kaien04/TTR9.5eco_VCU/README.md

# TTR9.5eco VCU 專案

This is for Taipei Tech Racing TTR9.5eco vehicle VCU project file

## 專案內容
- VCU 相關電路設計圖

## 開發資訊
- 開發者：陳楷恩
- 適用賽事：節能車大賽 / FSAE相關規格參考
