kaien04/TTR9.5eco_VCU/TTR9.5eco-VCU/Hardware/release/v2.0/3dmodel/TTR9.5eco_VCU.step

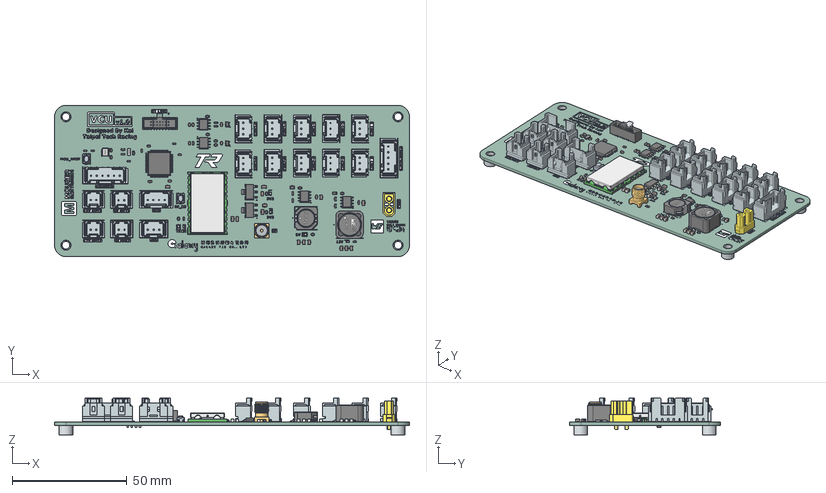
[picture p1: CAD file, 2026-05-07]
TTR9.5eco-VCU/Hardware/release/v2.0/3dmodel/TTR9.5eco_VCU.step
154.9 x 66.0 x 16.0 mm
R_0603_1608Metric x 18
C_0805_2012Metric x 15
C_0603_1608Metric x 25
Texas_HTSOP-8-1EP_3.9x4.9mm_P1.27mm_EP2.85x4.9mm_Mask2.4x3.1mm_ ThermalVias x 2
SOT-323_SC-70 x 2
Pins x 2
Cover x 2
LED_0603_1608Metric x 6
TTR9.5eco_VCU 1.38 x 2
Core
ShieldRing
Glue
Leadframe
SOIC-8_3.9x4.9mm_P1.27mm x 2
R_0805_2012Metric x 2
SOT-223 x 2
PCB
asmPad x 16
solderPin x 23
AMB004F
AMB004C
shielding ring
core
base x 2
glue
XT30_Buchse
LQFP-64_10x10mm_P0.5mm
6270xx20621_PIN x 14
6273xx20621_Cap
L_0603_1608Metric
TTR9.5eco_VCU_silkscreen
TTR9.5eco_VCU_PCB
