kaien04/TTR9.5eco_VCU/TTR9.5eco-VCU/Hardware/release/v2.0/schematic/TTR9.5eco_VCU.pdf

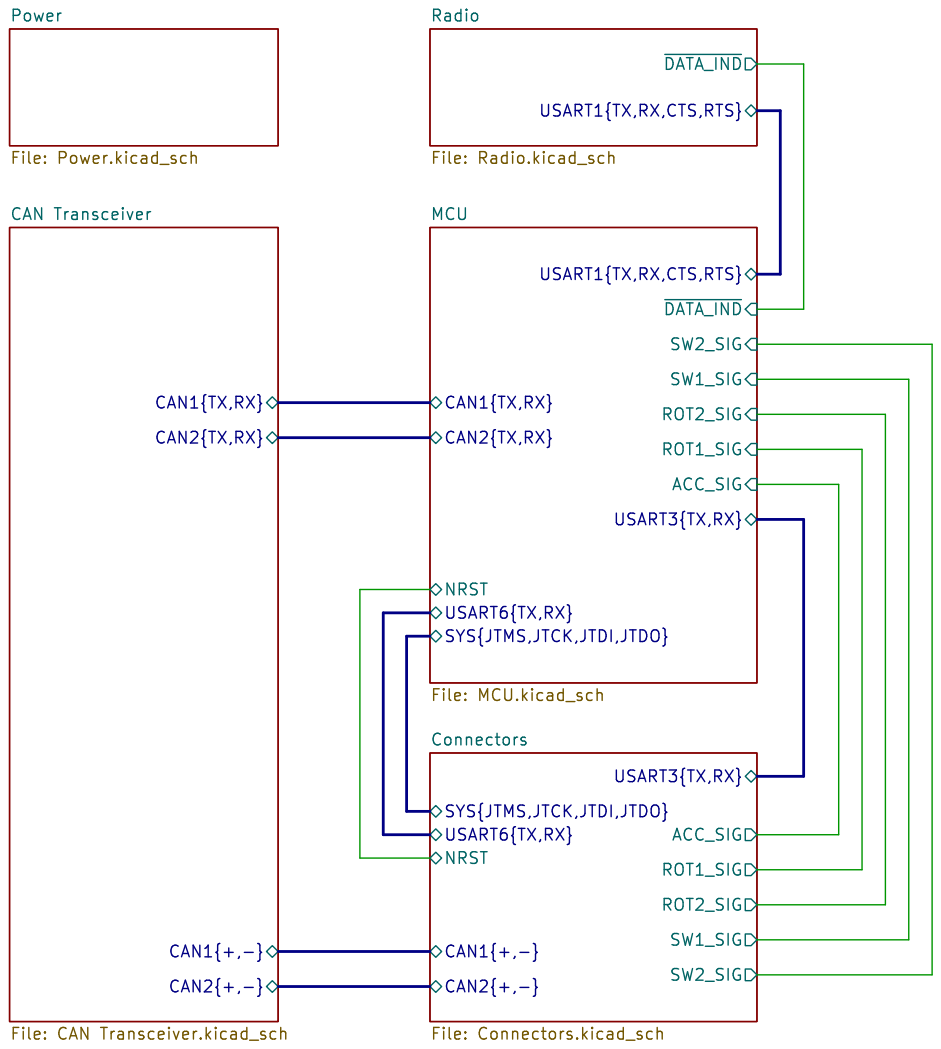
[picture p2: page 1]

USART1{TX,RX,CTS,RTS} ROT1_SIG

USART6{TX,RX}
SYS{JTMS,JTCK,JTDI,JTDO}

USART6{TX,RX} Connectors File: Connectors.kicad_sch

NRST SYS{JTMS,JTCK,JTDI,JTDO}

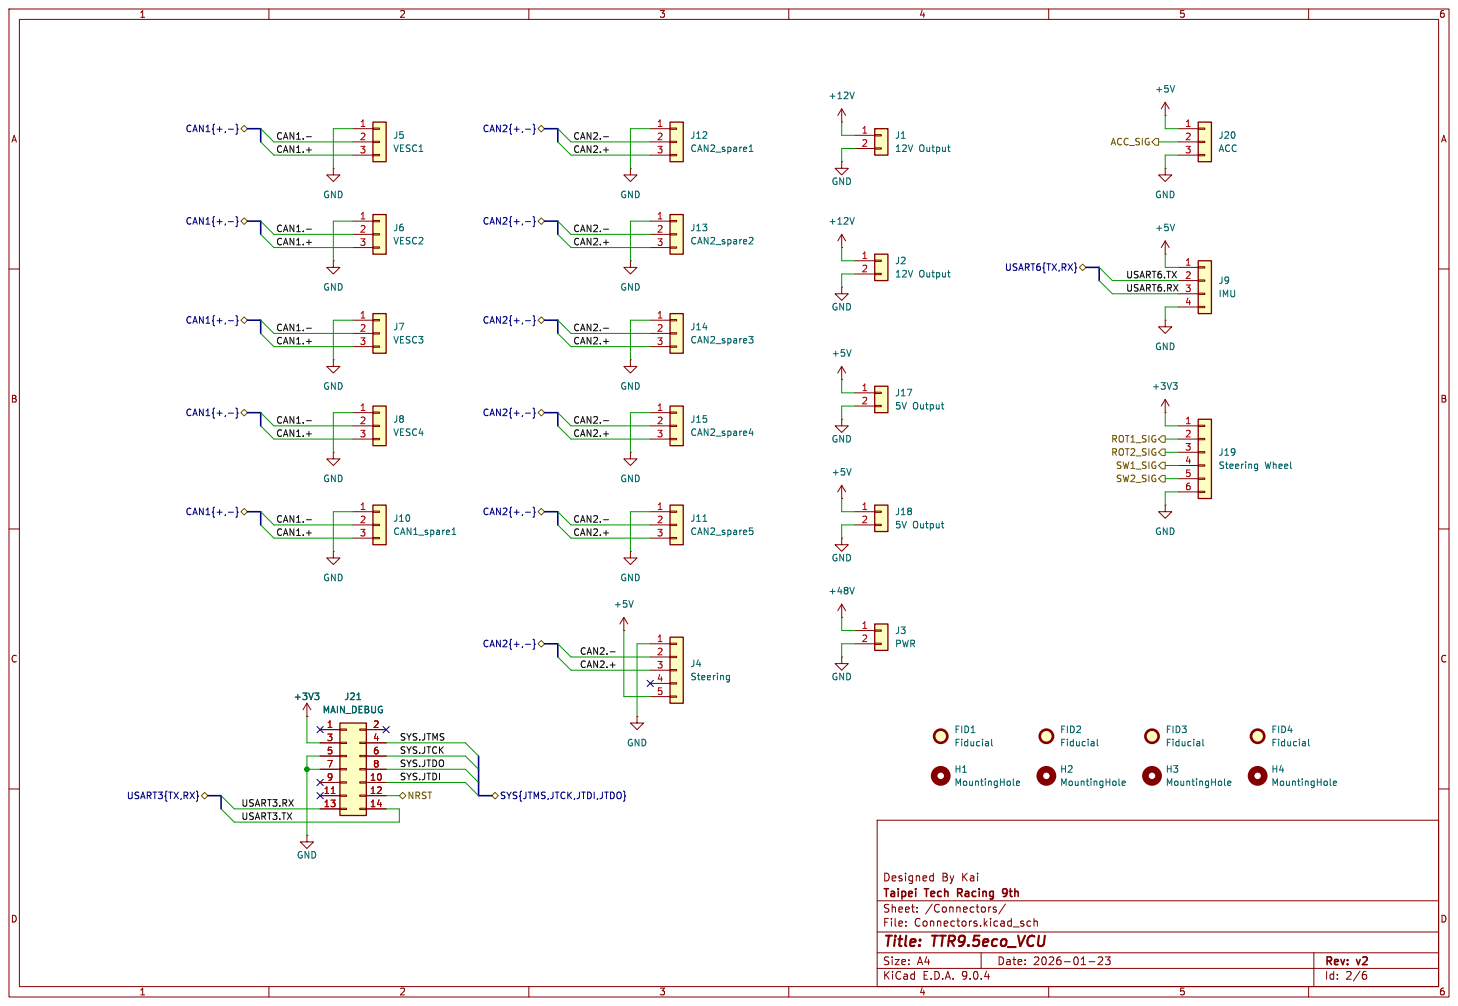
[picture p3: page 2]

SYS{JTMS,JTCK,JTDI,JTDO}

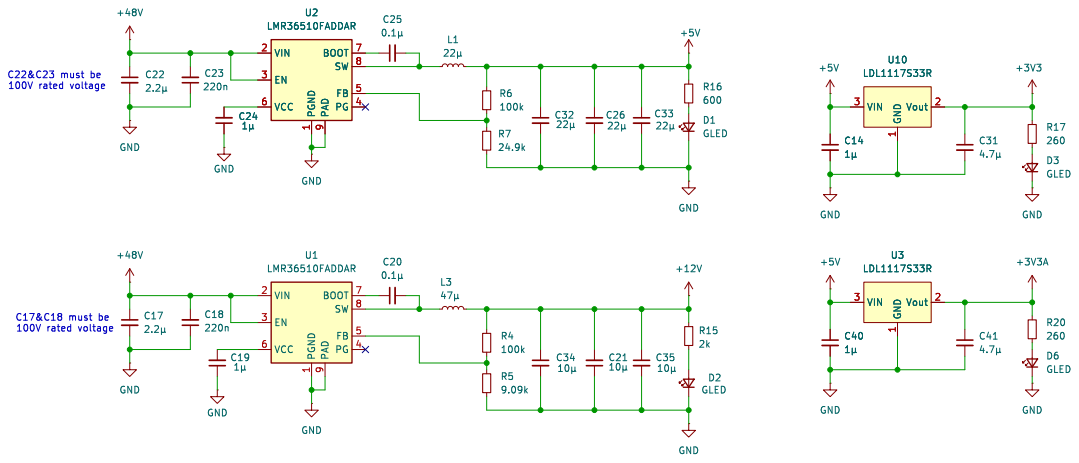
[picture p4: page 3]

100V rated voltage C17&C18 must be

9 BOOT 7 SW 8 FB 5 PG 4 U3

9 BOOT 7 SW 8 FB 5 PG 4 U1

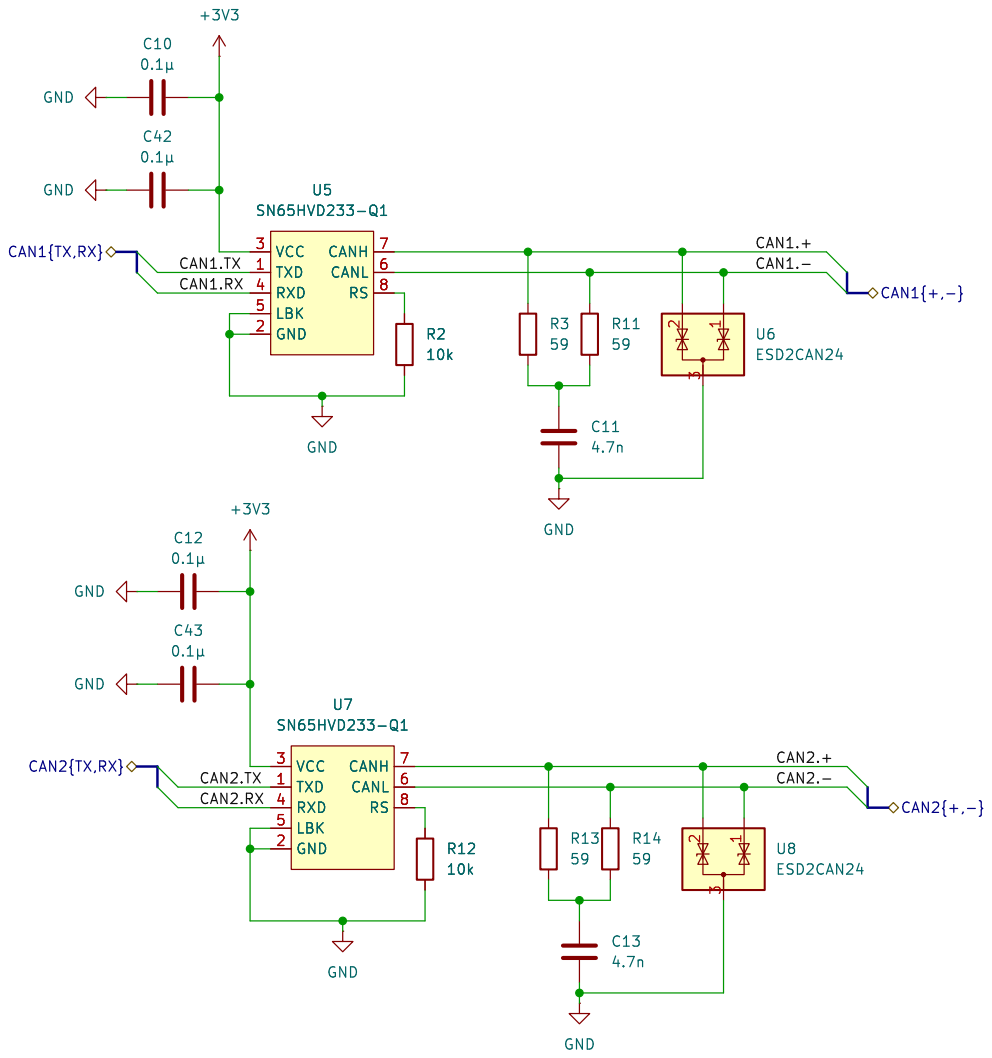
[picture p5: page 4]

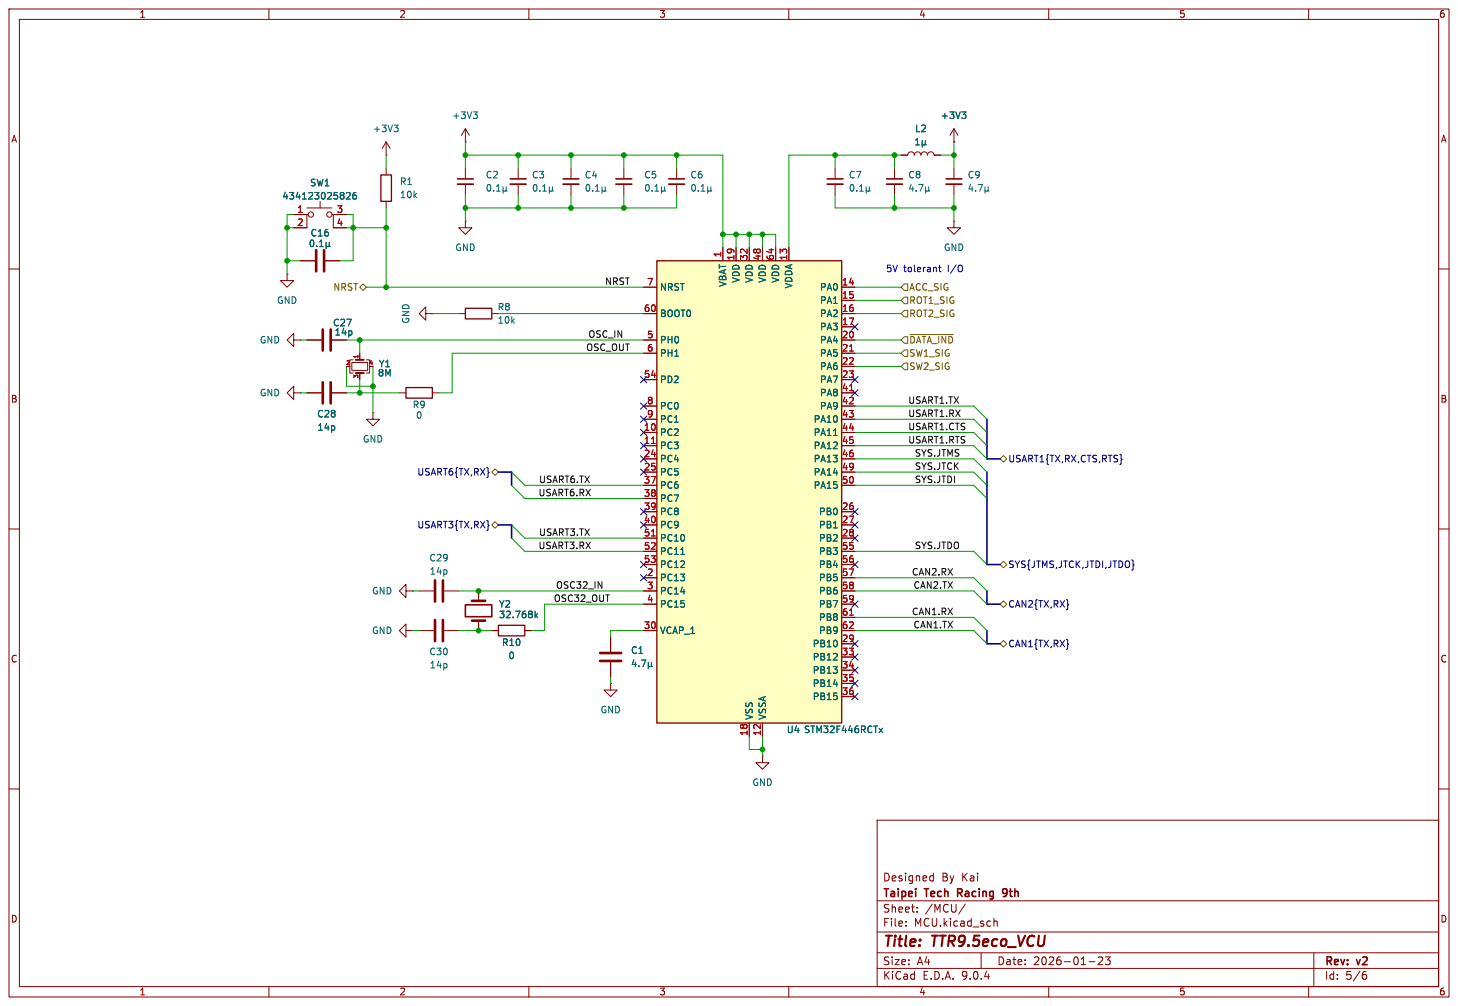
[picture p6: page 5]

USART1{TX,RX,CTS,RTS} ACC_SIG

USART1.TX USART3.RX USART3.TX USART6.TX USART6.RX OSC32_OUT OSC32_IN

SYS.JTDI SYS.JTMS

SYS{JTMS,JTCK,JTDI,JTDO}

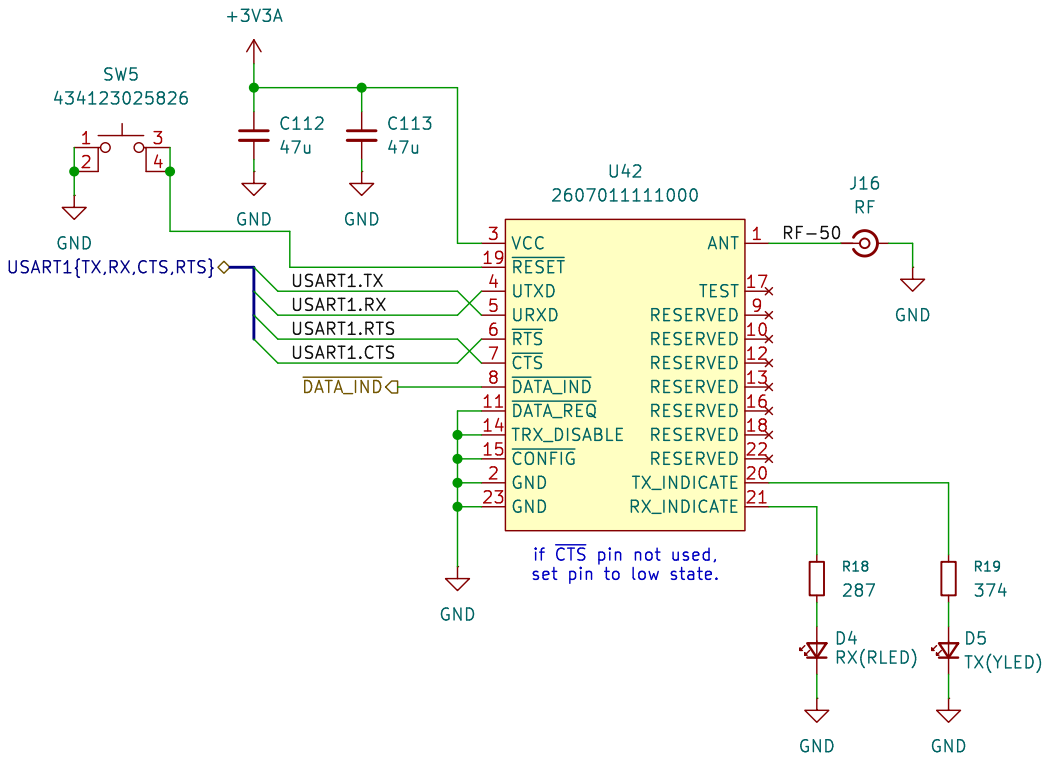
[picture p7: page 6]

if ~{CTS}pin not used, set pin to low state.
