kaien04/TTR9.5eco_VCU/TTR9.5eco-VCU/Hardware/TTR9.5eco_VCU.kicad_pcb

## KiCad design TTR9.5eco-VCU/Hardware/TTR9.5eco_VCU.kicad_pcb (2026-05-07)

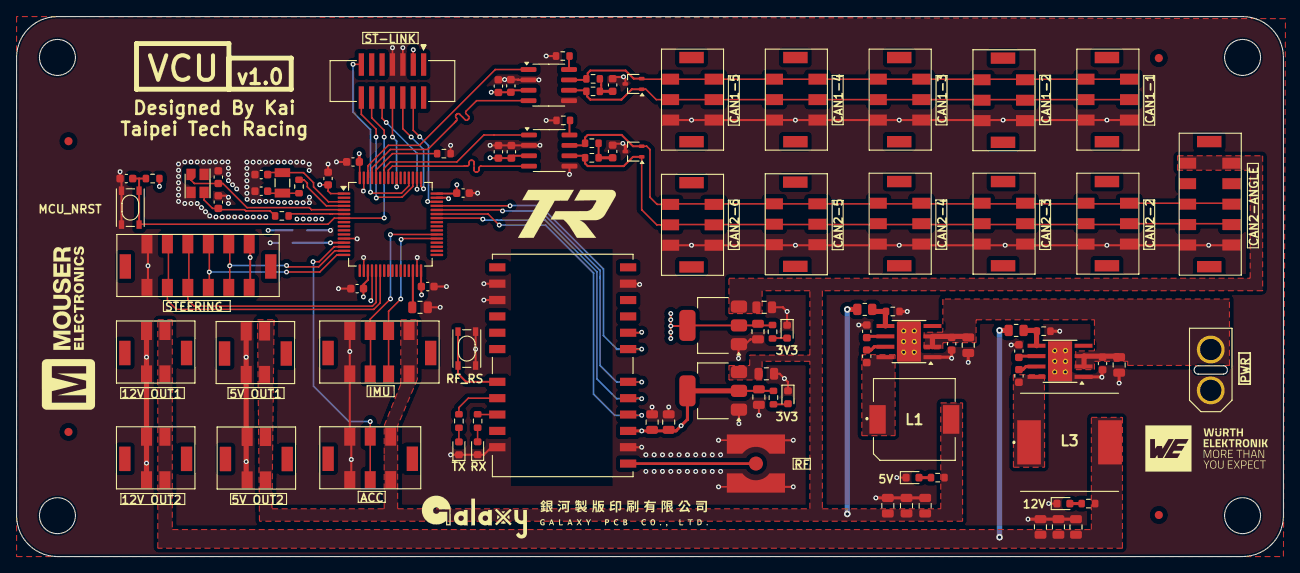
[picture p8: board TTR9.5eco_VCU.kicad_pcb from above]

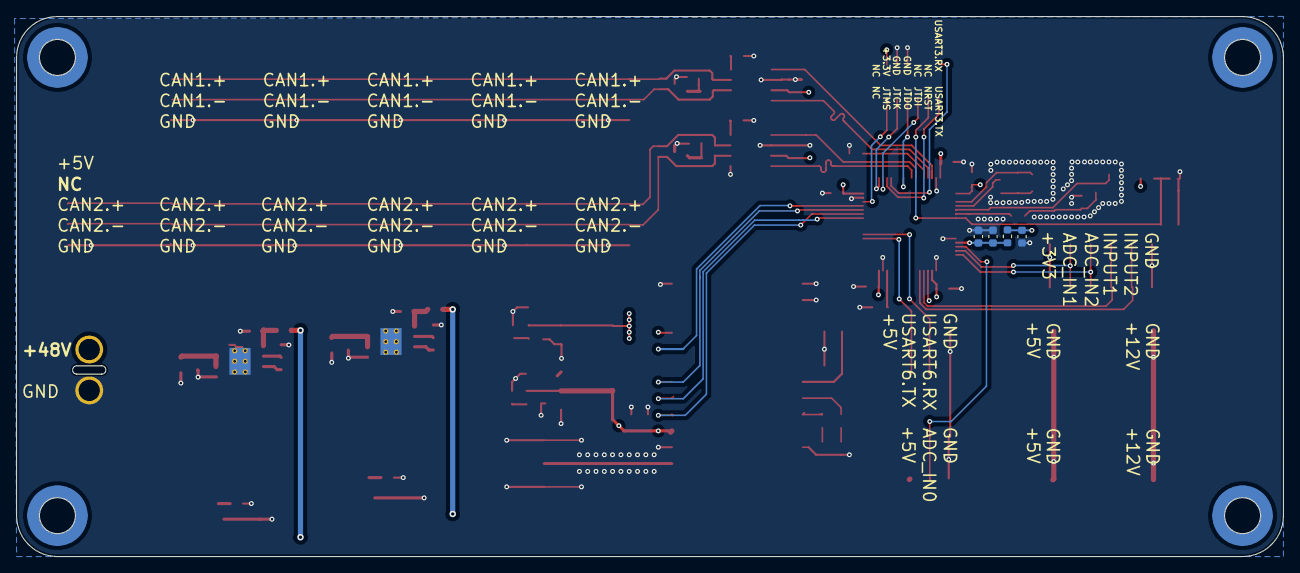
[picture p9: board TTR9.5eco_VCU.kicad_pcb from below]

Board: 4 copper layers, 154.9 x 66.0 mm, 112 parts (8 on the bottom side), 64 nets.

Parts:
C1, C31, C41: 4.7μ; C_0805_2012Metric
C2, C3, C4, C5, C6, C7, C10, C12, C16, C20, C25, C42, C43: 0.1μ; C_0603_1608Metric
C8, C9: 4.7μ; C_0603_1608Metric
C11, C13: 4.7n; C_0603_1608Metric
C14, C40: 1μ; C_0805_2012Metric
C17, C22: 2.2μ; C_0805_2012Metric
C18, C23: 220n; C_0603_1608Metric
C19, C24: 1μ; C_0603_1608Metric
C21, C34, C35: 10μ; C_0805_2012Metric
C26, C32, C33: 22μ; C_0805_2012Metric
C27, C28, C29, C30: 14p; C_0603_1608Metric
C112, C113: 47u; C_0805_2012Metric
D1, D2, D3, D6: GLED; LED_0603_1608Metric
D4: RX(RLED); LED_0603_1608Metric
D5: TX(YLED); LED_0603_1608Metric
FID1, FID2, FID3, FID4: Fiducial; Fiducial_1mm_Mask2mm
H1, H2, H3, H4: MountingHole; 786140x0x60
J1, J2: 12V Output; 2159310270
J3: PWR; XT30-F
J4: Steering; 2159310570
J5: VESC1; 2159310370
J6: VESC2; 2159310370
J7: VESC3; 2159310370
J8: VESC4; 2159310370
J9: IMU; 2159310470
J10: CAN1_spare1; 2159310370
J11: CAN2_spare5; 2159310370
J12: CAN2_spare1; 2159310370
J13: CAN2_spare2; 2159310370
J14: CAN2_spare3; 2159310370
J15: CAN2_spare4; 2159310370
J16: RF; 60312102114405
J17, J18: 5V Output; 2159310270
J19: Steering Wheel; 2159310670
J20: ACC; 2159310370
J21: MAIN_DEBUG; 62731420621
L1: 22μ; 7447714220
L2: 1μ; L_0603_1608Metric
L3: 47μ; WE-PD_1260_1245_1280_121054
R1, R2, R8, R12: 10k; R_0603_1608Metric
R3, R11, R13, R14: 59; R_0603_1608Metric
R4, R6: 100k; R_0805_2012Metric
R5: 9.09k; R_0603_1608Metric
R7: 24.9k; R_0603_1608Metric
R9, R10: 0; R_0603_1608Metric
R15: 2k; R_0603_1608Metric
R16: 600; R_0603_1608Metric
R17, R20: 260; R_0603_1608Metric
R18: 287; R_0603_1608Metric
R19: 374; R_0603_1608Metric
SW1, SW5: 434123025826
U1, U2: LMR36510FADDAR; Texas_HTSOP-8-1EP_3.9x4.9mm_P1.27mm_EP2.95x4.9mm_Mask2.4x3.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
U3, U10: LDL1117S33R; SOT-223-3_TabPin2
U4: STM32F446RCTx; LQFP-64_10x10mm_P0.5mm
U5, U7: SN65HVD233-Q1; SOIC-8_3.9x4.9mm_P1.27mm
U6, U8: ESD2CAN24; SOT-323_SC-70
U42: 2607011111000
Y1: 8M; WE-CFPX-180
Y2: 32.768k; WE-CFPX-217

Connections:
+3V3: C2.1, C3.1, C4.1, C5.1, C6.1, C9.1, C10.2, C12.2, C31.1, C42.2, C43.2, J19.1, J21.3, L2.2, R1.2, R17.1, U4.1 (VBAT), U4.19 (VDD), U4.32 (VDD), U4.48 (VDD), U4.64 (VDD), U5.3 (VCC), U7.3 (VCC), U10.2 (Vout)
+3V3A: C41.1, C112.1, C113.1, R20.1, U3.2 (Vout), U42.3 (VCC)
+5V: C14.1, C26.1, C32.1, C33.1, C40.1, J4.5, J9.1, J17.1, J18.1, J20.1, L1.2, R6.1, R16.1, U3.3 (VIN), U10.3 (VIN)
+12V: C21.2, C34.1, C35.1, J1.1, J2.1, L3.2, R4.2, R15.1
+48V: C17.1, C18.2, C22.1, C23.2, J3.1, U1.2 (VIN), U1.3 (EN), U2.2 (VIN), U2.3 (EN)
/CAN Transceiver/CAN1.+: J5.3, J6.3, J7.3, J8.3, J10.3, R3.1, U5.7 (CANH), U6.2
/CAN Transceiver/CAN1.-: J5.2, J6.2, J7.2, J8.2, J10.2, R11.1, U5.6 (CANL), U6.1
/CAN Transceiver/CAN1.RX: U4.61 (PB8), U5.4 (RXD)
/CAN Transceiver/CAN1.TX: U4.62 (PB9), U5.1 (TXD)
/CAN Transceiver/CAN2.+: J4.3, J11.3, J12.3, J13.3, J14.3, J15.3, R13.1, U7.7 (CANH), U8.2
/CAN Transceiver/CAN2.-: J4.2, J11.2, J12.2, J13.2, J14.2, J15.2, R14.1, U7.6 (CANL), U8.1
/CAN Transceiver/CAN2.RX: U4.57 (PB5), U7.4 (RXD)
/CAN Transceiver/CAN2.TX: U4.58 (PB6), U7.1 (TXD)
/Connectors/ACC_SIG: J20.2, U4.14 (PA0)
/Connectors/ROT1_SIG: J19.2, U4.15 (PA1)
/Connectors/ROT2_SIG: J19.3, U4.16 (PA2)
/Connectors/SW1_SIG: J19.4, U4.21 (PA5)
/Connectors/SW2_SIG: J19.5, U4.22 (PA6)
/Connectors/SYS.JTCK: J21.6, U4.49 (PA14)
/Connectors/SYS.JTDI: J21.10, U4.50 (PA15)
/Connectors/SYS.JTDO: J21.8, U4.55 (PB3)
/Connectors/SYS.JTMS: J21.4, U4.46 (PA13)
/Connectors/USART3.RX: J21.13, U4.52 (PC11)
/Connectors/USART3.TX: J21.14, U4.51 (PC10)
/Connectors/USART6.RX: J9.3, U4.38 (PC7)
/Connectors/USART6.TX: J9.2, U4.37 (PC6)
/MCU/NRST: C16.2, J21.12, R1.1, SW1.3, SW1.4, U4.7 (NRST)
/MCU/OSC32_IN: C29.2, U4.3 (PC14), Y2.2
/MCU/OSC32_OUT: R10.2, U4.4 (PC15)
/MCU/OSC_IN: C27.2, U4.5 (PH0), Y1.1
/MCU/OSC_OUT: R9.2, U4.6 (PH1)
/MCU/USART1.CTS: U4.44 (PA11), U42.6 (~RTS)
/MCU/USART1.RTS: U4.45 (PA12), U42.7 (~CTS)
/MCU/USART1.RX: U4.43 (PA10), U42.4 (UTXD)
/MCU/USART1.TX: U4.42 (PA9), U42.5 (URXD)
/MCU/~DATA_IND: U4.20 (PA4), U42.8 (~DATA_IND)
/Radio/RF-50: J16.1 (In), U42.1 (ANT)
GND: C1.2, C2.2, C3.2, C4.2, C5.2, C6.2, C7.2, C8.2, C9.2, C10.1, C11.2, C12.1, C13.2, C14.2, C16.1, C17.2, C18.1, C19.1, C21.1, C22.2, C23.1, C24.1, C26.2, C27.1, C28.1, C29.1, C30.1, C31.2, C32.2, C33.2, C34.2, C35.2, C40.2, C41.2, C42.1, C43.1, C112.2, C113.2, D1.1 (K), D2.1 (K), D3.1 (K), D4.1 (K), D5.1 (K), D6.1 (K), J1.2, J2.2, J3.2, J4.1, J5.1, J6.1, J7.1, J8.1, J9.4, J10.1, J11.1, J12.1, J13.1, J14.1, J15.1, J16.2 (Ext), J17.2, J18.2, J19.6, J20.3, J21.5, J21.7, R2.2, R5.2, R7.2, R8.2, R12.2, SW1.1, SW1.2, SW5.1, SW5.2, U1.1 (PGND), U1.9 (PAD), U2.1 (PGND), U2.9 (PAD), U3.1 (GND), U4.12 (VSSA), U4.18 (VSS), U4.31 (VSS), U4.47 (VSS), U4.63 (VSS), U5.2 (GND), U5.5 (LBK), U6.3, U7.2 (GND), U7.5 (LBK), U8.3, U10.1 (GND), U42.2 (GND), U42.11 (~DATA_REQ), U42.14 (TRX_DISABLE), U42.15 (~CONFIG), U42.23 (GND), Y1.2, Y1.4
unnamed: C11.1, R3.2, R11.2
unnamed: C13.1, R13.2, R14.2
unnamed: C28.2, R9.1, Y1.3
unnamed: C30.2, R10.1, Y2.1
unnamed: D1.2 (A), R16.2
unnamed: D2.2 (A), R15.2
unnamed: D3.2 (A), R17.2
unnamed: D4.2 (A), R18.2
unnamed: D5.2 (A), R19.2
unnamed: D6.2 (A), R20.2
unnamed: C20.1, U1.7 (BOOT)
unnamed: R4.1, R5.1, U1.5 (FB)
unnamed: C20.2, L3.1, U1.8 (SW)
unnamed: C19.2, U1.6 (VCC)
unnamed: C25.1, U2.7 (BOOT)
unnamed: R6.2, R7.1, U2.5 (FB)
unnamed: C25.2, L1.1, U2.8 (SW)
unnamed: C24.2, U2.6 (VCC)
unnamed: R8.1, U4.60 (BOOT0)
unnamed: C1.1, U4.30 (VCAP_1)
unnamed: C7.1, C8.1, L2.1, U4.13 (VDDA)
unnamed: R2.1, U5.8 (RS)
unnamed: R12.1, U7.8 (RS)
unnamed: R18.1, U42.21 (RX_INDICATE)
unnamed: R19.1, U42.20 (TX_INDICATE)
unnamed: SW5.3, SW5.4, U42.19 (~RESET)
